andrew33bird/alarm_clock/Housing/dimensions.pdf

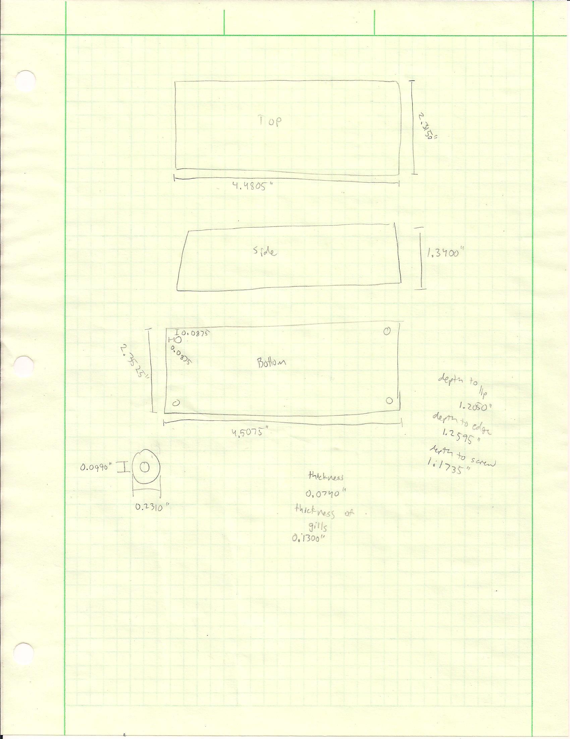
[picture p1: page 1]
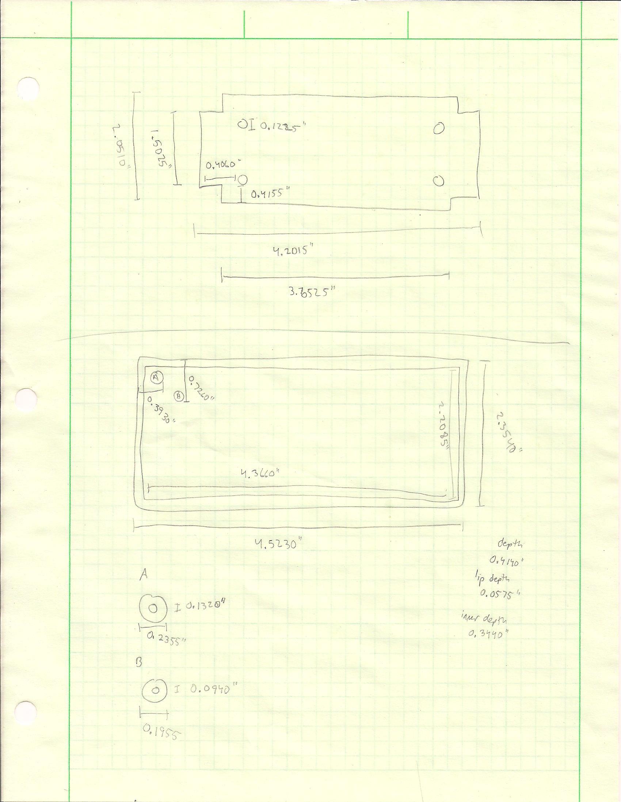
[picture p2: page 2]
