andrew33bird/alarm_clock/bom.xlsx

Item | Part Number | Qnty | Price (ea) | Price (tot) | Distributor | Link
Microcontroller | ATMEGA328P-PU | 1 | $2.60 | $2.60 | Amazon | https://www.amazon.com/gp/product/B07BZMCK8S/ref=oh_aui_detailpage_o03_s00?ie=UTF8&psc=1
5V Regulator | NCP1117ST50T3G | 1 | $0.54 | $0.54 | Digikey | https://www.digikey.com/product-detail/en/on-semiconductor/NCP1117ST50T3G/NCP1117ST50T3GOSCT-ND/1967217
47 uF Capacitor | 860020472006 | 2 | $0.10 | $0.20 | Digikey | https://www.digikey.com/product-detail/en/wurth-electronics-inc/860020472006/732-8823-1-ND/5728768
Power Diode | 1N4007-TP | 1 | $0.11 | $0.11 | Digikey | https://www.digikey.com/product-detail/en/micro-commercial-co/1N4007-TP/1N4007-TPMSCT-ND/773694
100 nF Capacitor | GRM033R61A104ME15D | 1 | $0.10 | $0.10 | Digikey | https://www.digikey.com/product-detail/en/murata-electronics-north-america/GRM033R61A104ME15D/490-5405-1-ND/2175212
16 MHz Crystal | 9B-16.000MAAJ-B | 1 | $0.39 | $0.39 | Digikey | https://www.digikey.com/products/en?keywords=887-1019-ND
22 pF Capacitor | 04025A220JAT2A | 2 | $0.10 | $0.20 | Digikey | https://www.digikey.com/product-detail/en/avx-corporation/04025A220JAT2A/478-1074-1-ND/564106
Tinted plastic (1/8" x 4" x 4" Sample) | Cast Acrylic - Transparent Colors (Trasparent Light Smoke) | 1 | $2.00 | $2.00 | Tap Plastics | https://www.tapplastics.com/product/plastics/plastic_sheets_rolls/acrylic_sheets_transparent_colors/519
10k Resistor | RMCF0201FT10K0 | 6 | $0.10 | $0.60 | Digikey | https://www.digikey.com/product-detail/en/stackpole-electronics-inc/RMCF0201FT10K0/RMCF0201FT10K0CT-ND/3931517
Power LED | 150060GS75000 | 1 | $0.15 | $0.15 | Digikey | https://www.digikey.com/product-detail/en/wurth-electronics-inc/150060GS75000/732-4971-1-ND/4489896
330 LED Resistor | CR0603-JW-331ELF | 1 | $0.10 | $0.10 | Digikey | https://www.digikey.com/product-detail/en/bourns-inc/CR0603-JW-331ELF/CR0603-JW-331ELFCT-ND/3767680
Programmer header | PREC004SAAN-RC | 1 | $0.12 | $0.12 | Digikey | https://www.digikey.com/product-detail/en/sullins-connector-solutions/PREC004SAAN-RC/S1012EC-04-ND/2774850
7-Segment Serial Display - Blue | COM-11442 | 1 | $13.95 | $13.95 | Sparkfun | https://www.sparkfun.com/products/11442
10-Segment Right angle header | 68015-410HLF | 1 | $0.45 | $0.45 | Digikey | https://www.digikey.com/product-detail/en/amphenol-icc-fci/68015-410HLF/609-6344-ND/5206612
Reset push button | COM-00097 | 1 | $0.35 | $0.35 | Sparkfun | https://www.sparkfun.com/products/97
500mA fuse | ERB-RE0R50V | 1 | $0.29 | $0.29 | Digikey | https://www.digikey.com/product-detail/en/panasonic-electronic-components/ERB-RE0R50V/P15127CT-ND/2796814
Large pushbutton | COM-09190 | 5 | $0.50 | $2.50 | Sparkfun | https://www.sparkfun.com/products/9190
Mini Piezo Speaker | CEM-1203(42) | 1 | $0.83 | $0.83 | Digikey | https://www.digikey.com/products/en?keywords=CEM-1203
Total |  |  |  | $25.48
