andrew33bird/alarm_clock/KiCAD/Source/AS.001_schematic.pdf

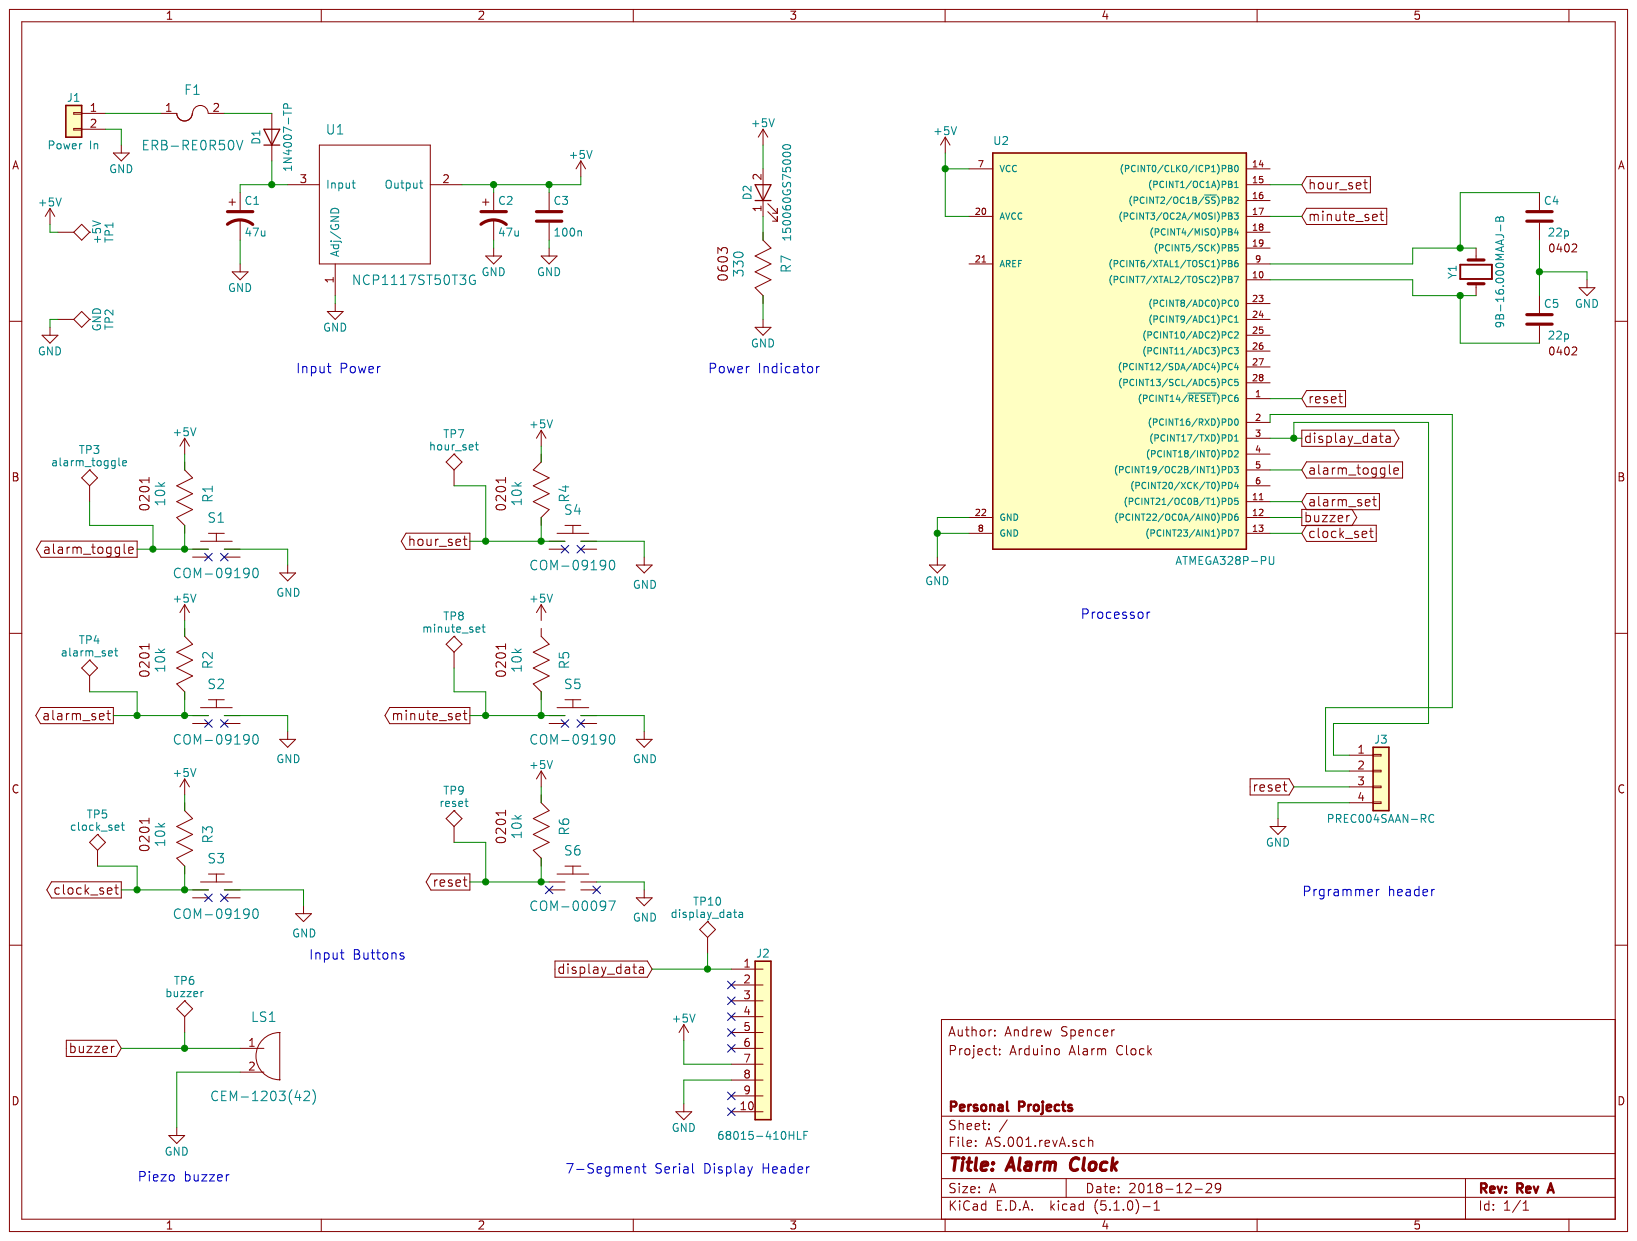
[picture p3: page 1]
