andrew33bird/alarm_clock/KiCAD/Source/AS.001.revA.kicad_pcb

## KiCad design KiCAD/Source/AS.001.revA.kicad_pcb (2020-03-28)

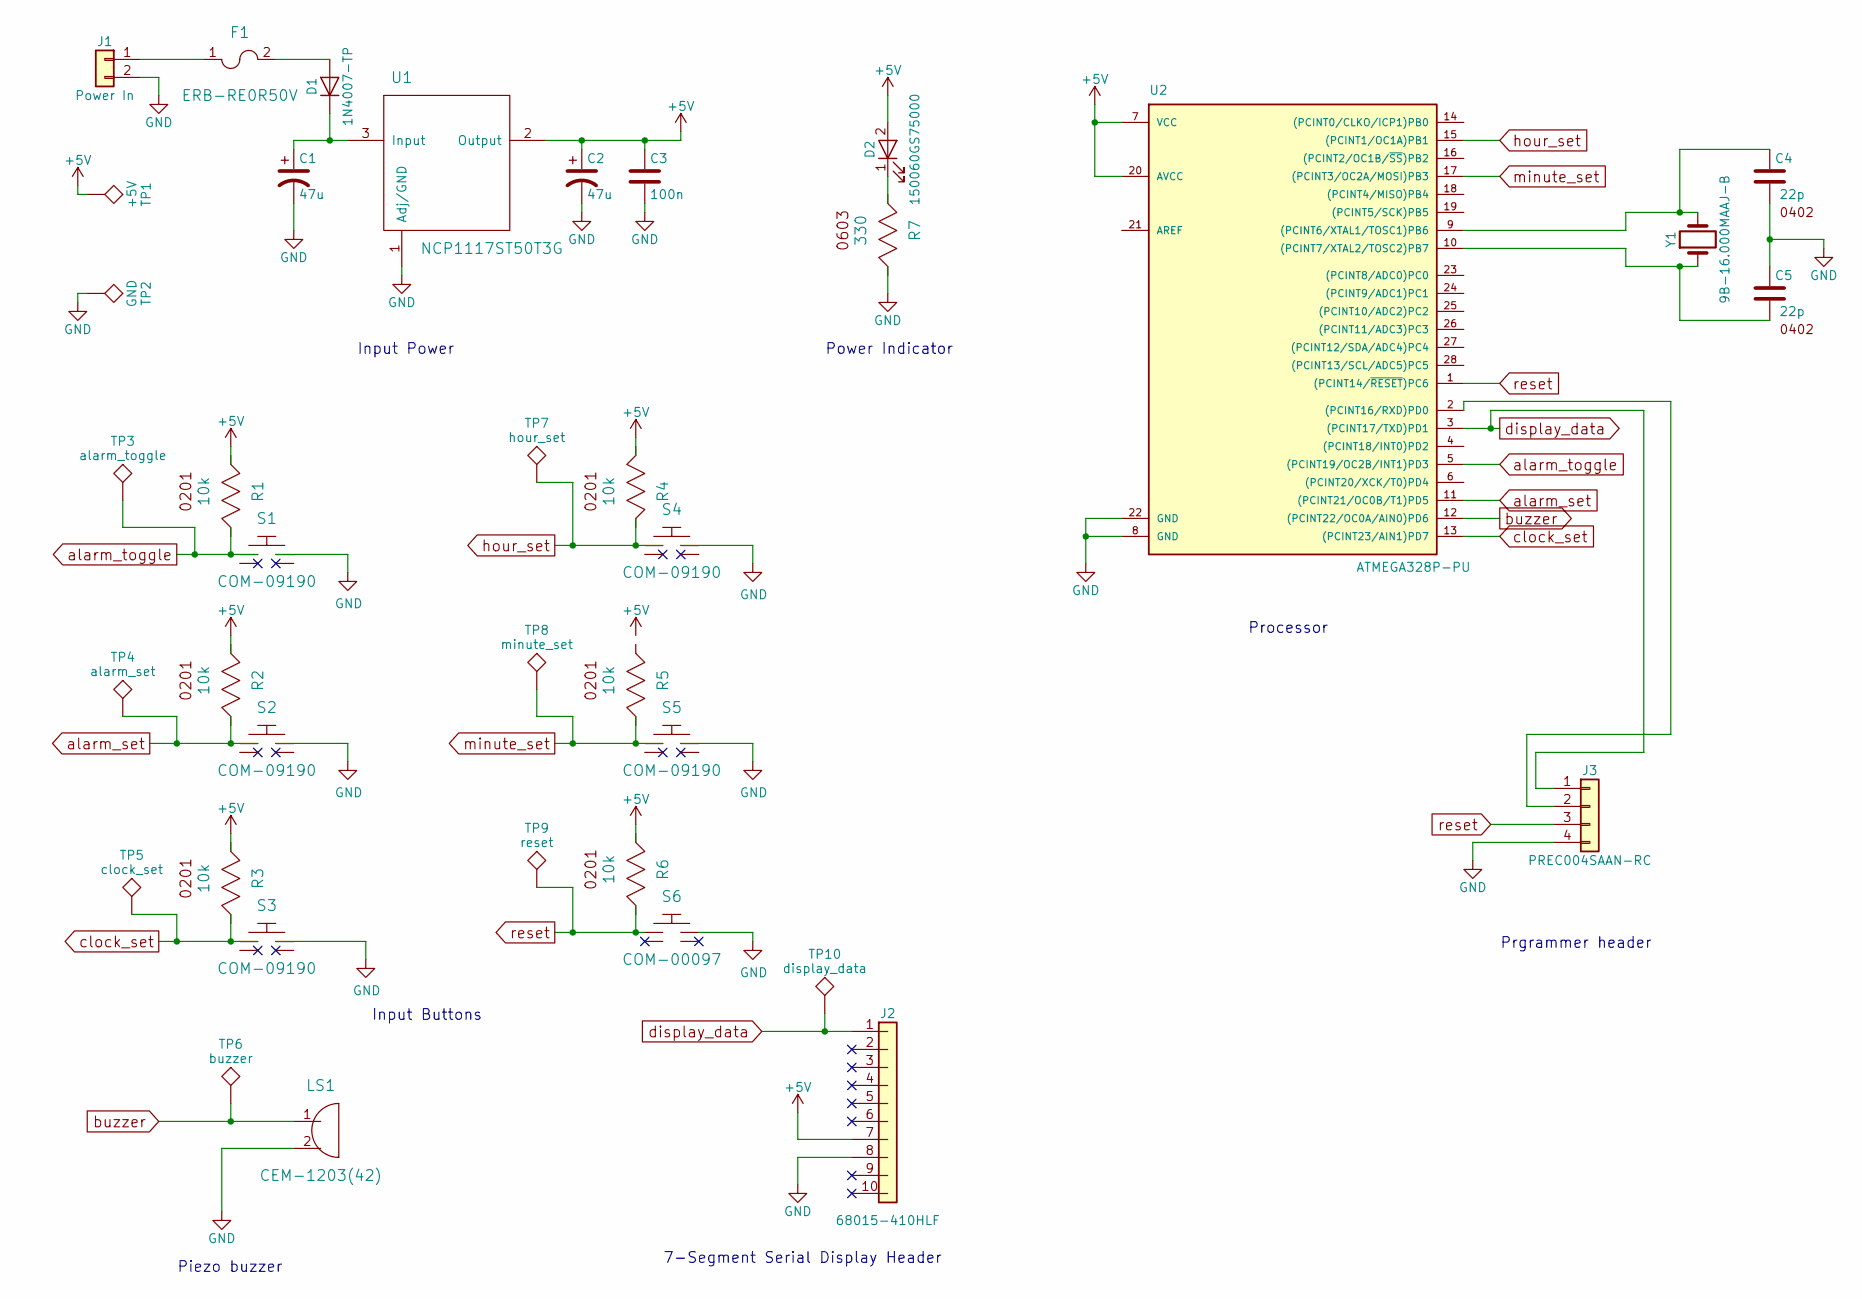
[picture p4: schematic AS.001.revA.sch, Alarm Clock]

Parts:
C1, C2: 47u; CP_Radial_D5.0mm_P2.00mm
C3: 100n; C_0603_1608Metric_Pad1.05x0.95mm_HandSolder
C4, C5: 22p; C_0603_1608Metric_Pad1.05x0.95mm_HandSolder
D1: 1N4007-TP; D_DO-41_SOD81_P10.16mm_Horizontal
D2: 150060GS75000; LED_0603_1608Metric_Pad1.05x0.95mm_HandSolder
F1: ERB-RE0R50V; R_0603_1608Metric_Pad1.05x0.95mm_HandSolder
J1: Power In; PinSocket_1x02_P2.54mm_Vertical
J2: 68015-410HLF; PinSocket_1x10_P2.54mm_Horizontal
J3: PREC004SAAN-RC; PinSocket_1x04_P2.54mm_Vertical
LS1: CEM-1203(42)
R1, R2, R3, R4, R5, R6: 10k; R_0603_1608Metric_Pad1.05x0.95mm_HandSolder
R7: 330; R_0603_1608Metric_Pad1.05x0.95mm_HandSolder
S1, S2, S3, S4, S5: COM-09190
S6: COM-00097
TP1: +5V; TestPoint_Plated_Hole_D2.0mm
TP2: GND; TestPoint_Plated_Hole_D2.0mm
TP3: alarm_toggle; TestPoint_Plated_Hole_D2.0mm
TP4: alarm_set; TestPoint_Plated_Hole_D2.0mm
TP5: clock_set; TestPoint_Plated_Hole_D2.0mm
TP6: buzzer; TestPoint_Plated_Hole_D2.0mm
TP7: hour_set; TestPoint_Plated_Hole_D2.0mm
TP8: minute_set; TestPoint_Plated_Hole_D2.0mm
TP9: reset; TestPoint_Plated_Hole_D2.0mm
TP10: display_data; TestPoint_Plated_Hole_D2.0mm
U1: NCP1117ST50T3G; NCP1117ST50T3G (TO-261-4)
U2: ATMEGA328P-PU; DIP-28_W7.62mm
Y1: 9B-16.000MAAJ-B; Crystal_HC49-U_Vertical

Connections:
+5V: C2.1, C3.1, D2.2 (A), J2.7, R1.1 (A), R2.1 (A), R3.1 (A), R4.2 (B), R6.1 (A), TP1.1, U1.2 (Output), U2.7 (VCC), U2.20 (AVCC); also elsewhere on the board
GND: C1.2, C2.2, C3.2, C4.2, C5.1, J1.2, J2.8, J3.4, LS1.2, R7.2 (B), S1.3 (C), S2.3 (C), S3.3 (C), S4.3 (C), S5.3 (C), S6.3 (C), TP2.1, U1.1 (Adj/GND), U2.8 (GND), U2.22 (GND); also elsewhere on the board
unnamed: C1.1, D1.1 (K), U1.3 (Input)
unnamed: C4.1, U2.9 ((PCINT6/XTAL1/TOSC1)PB6), Y1.2
unnamed: C5.2, U2.10 ((PCINT7/XTAL2/TOSC2)PB7), Y1.1
unnamed: D1.2 (A), F1.2
unnamed: D2.1 (K), R7.1 (A)
unnamed: F1.1, J1.1
unnamed: J3.2, U2.2 ((PCINT16/RXD)PD0)
alarm_set: R2.2 (B), S2.1 (A), TP4.1, U2.11 ((PCINT21/OC0B/T1)PD5)
alarm_toggle: R1.2 (B), S1.1 (A), TP3.1, U2.5 ((PCINT19/OC2B/INT1)PD3)
buzzer: LS1.1, TP6.1, U2.12 ((PCINT22/OC0A/AIN0)PD6)
clock_set: R3.2 (B), S3.1 (A), TP5.1, U2.13 ((PCINT23/AIN1)PD7)
display_data: J2.1, J3.1, TP10.1, U2.3 ((PCINT17/TXD)PD1)
hour_set: R4.1 (A), S4.1 (A), TP7.1, U2.15 ((PCINT1/OC1A)PB1)
minute_set: R5.2 (B), S5.1 (A), TP8.1, U2.17 ((PCINT3/OC2A/MOSI)PB3)
reset: J3.3, R6.2 (B), S6.1 (A), TP9.1, U2.1 ((PCINT14/~RESET~)PC6)

Notes on the sheet:
Input Power
Input Buttons
Power Indicator
Piezo buzzer
7-Segment Serial Display Header
Processor
Prgrammer header

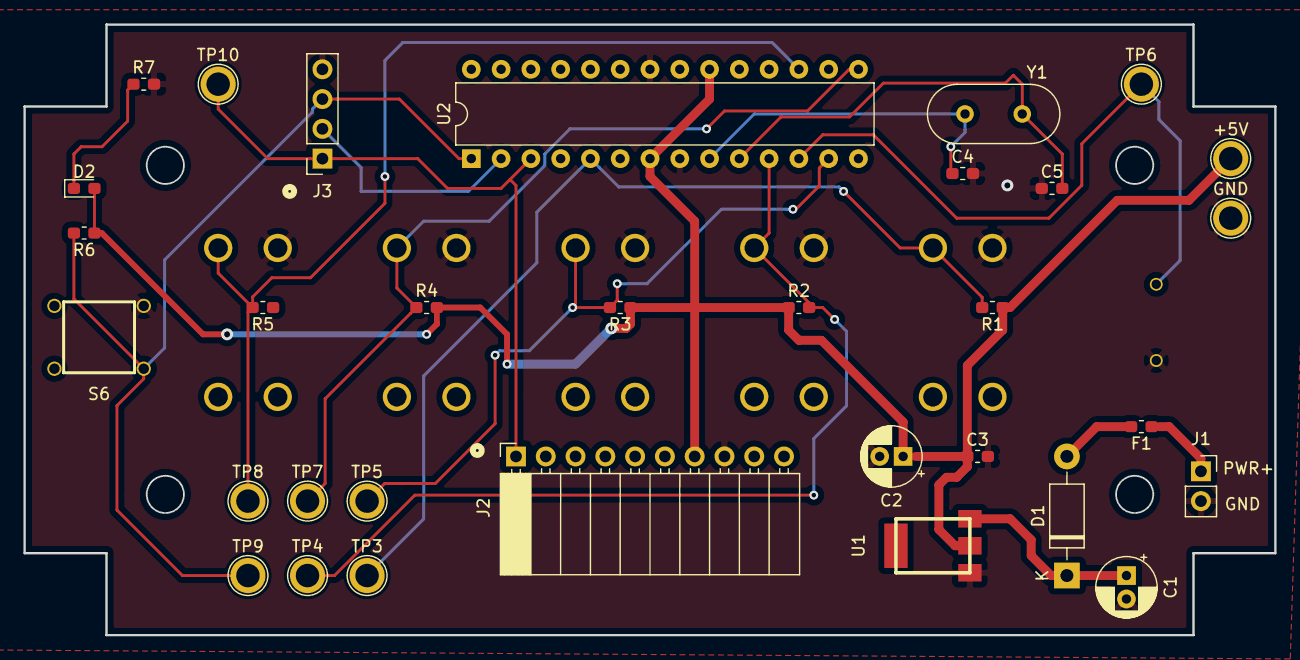
[picture p5: board AS.001.revA.kicad_pcb from above]

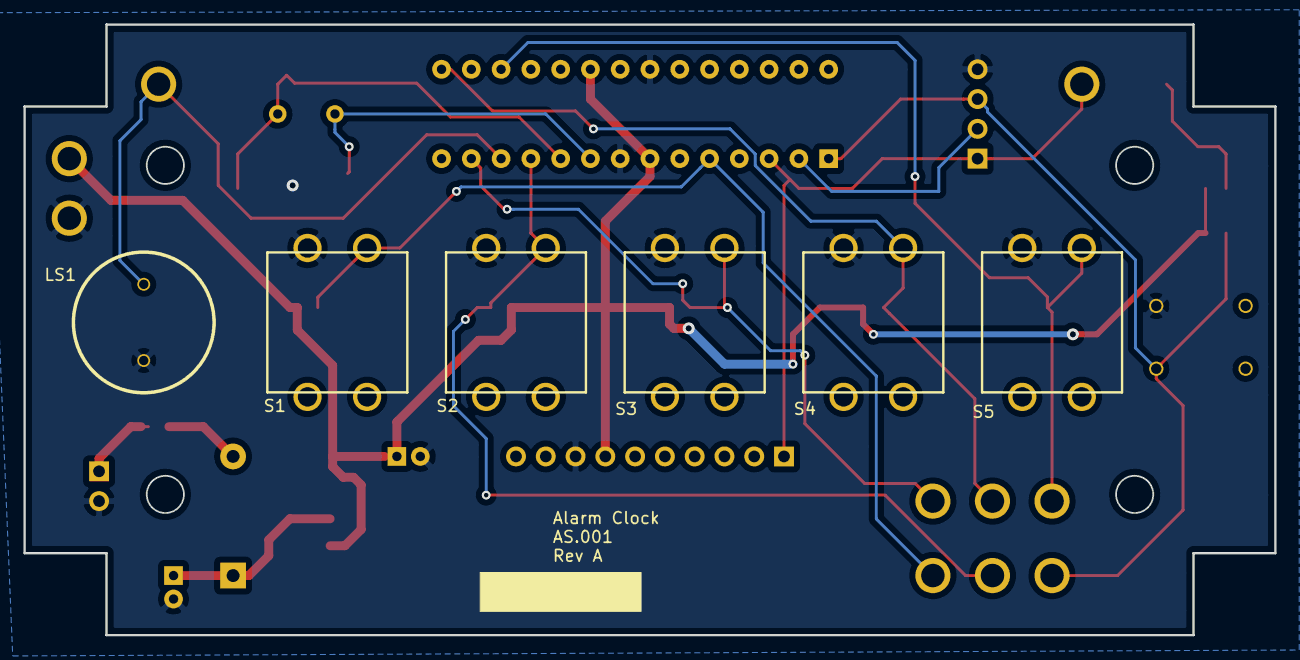
[picture p6: board AS.001.revA.kicad_pcb from below]

Board: 2 copper layers, 106.7 x 52.1 mm, 38 parts (6 on the bottom side), 17 nets.

Other parts of the board:
+5V: +5V; TestPoint_Plated_Hole_D2.0mm
GND: GND; TestPoint_Plated_Hole_D2.0mm

Their connections:
+5V: +5V.1; also elsewhere on the board
GND: GND.1; also elsewhere on the board
